Stinkpilot/ECEN404/README.md

ECEN 404 Team 10 Wildfire Detection Device

Mevin Ansa - Power and MCU Subsystem

Joshua Hornsey - Image Processing Subsystem

Kelli Templeton - User Communication Subsystem

Michael Zebe - Sensors Subsystem
