Stinkpilot/ECEN404/Archived Files/README.md

# ECEN404
ECEN 404 Wildfire Project

9/16/19 Update:

Kelli Templeton:
1. Tested the UART retrieval and parsing code for the MCU-GSM integration (uploaded code today 9/16/19)
2. Finalized the web application (will upload code today 9/16/19)
3. Created the initial physical container 
4. Began the design of the mobile PCB. 

Joshua Hornsey:
1. Worked on the camera4
2. Finished tutorial on Mask R-CNN object detection models
3. Finished tutorial on YOLO object detection models

Mevin Ansa:

1.Begun to program UART data frames to GSM module

2.Begun to program GPS module to microcontroller

3.Begun design of PCB for power supply

9/23/19 Update:

Kelli Templeton:
1. Integrated GSM module with ODROID successfully which invovled:
  1.1 Integrating GSM module with Arduino for communication testing
  1.2 Testing viable types of messages (strings, dictionaries, byte arrays)
  1.3 Integrating message receiving and parsing code with MQTT code
  1.4 Validating message accuracy

9/26/19 Update:

Kelli Templeton:
1. Validated connection of ODROID and GSM module
2. Wrote initial camera integration code
3. Wrote initial code to pull sensor data and format it into expected string

10/3/19 Update:

Kelli Templeton:
1. Tested and improved camera integration code

10/14/19 Update:

Kelli Templeton:
1. Installed all correct image processing dependencies on ODROID
2. Succesfully ran image processing model on ODROID
3. Wrote, tested, and finalized code to pull data from main module sensors every 5 minutes
4. Wrote initial code to pull data from gps module and remote module
5. Wrote initial code for camera - image processing model integration

10/24/19 Update:

1. Final testing and integration of code that pulls data from sensors every 5 minutes
2. Final testing of camera and image processing integration code
3. Discovered that the serial pin for the connection from the odroid to the gsm was dead - corrected the problem by adding USB to serial converter and implemented that successfully
4. Discovered that looping the image processing and camera code would create a memory allocation error
5. Solved the problem with a bash script that will build and break down the python code upon each loop
6. Modified sensor c code
7. Wrote tested and finalized code to pull data from gps and remote module 
8. Successfully ran full integration code from sensors, gps, and remote module to gsm module and web application
9. HIT SUCCESSFUL INTEGRATION BENCHMARK! 

10/28/19 Update:

Kelli Templeton
1. Fabricated device container
2. Validated Sensors
3. Wrote tested and finalized code for resetting GSM module off of PCB

11/4/19 Update:

Kelli Templeton
1. Finalization of fabriced device container design
2. Initial placement of hardware in device container
3. Finalization and testing of completed main bash script
4. Validation of entire device (with large fire / smoke source)
5. Final subsystem validation

11/11/19 Update:

Kelli Templeton
1. Wired and permanently placed the hardware in the device container
2. Configured ODROID to run bash script on boot using systemd
3. Tested and validated running bash script on boot
4. Validation of full device running on boot

11/18/19 Update:

Kelli Templeton
1. Compiling all validation information for demo binder
